RaX0r39/Trakya-Rocket-Unfinished/avionics/RakentenGörevyükü.png

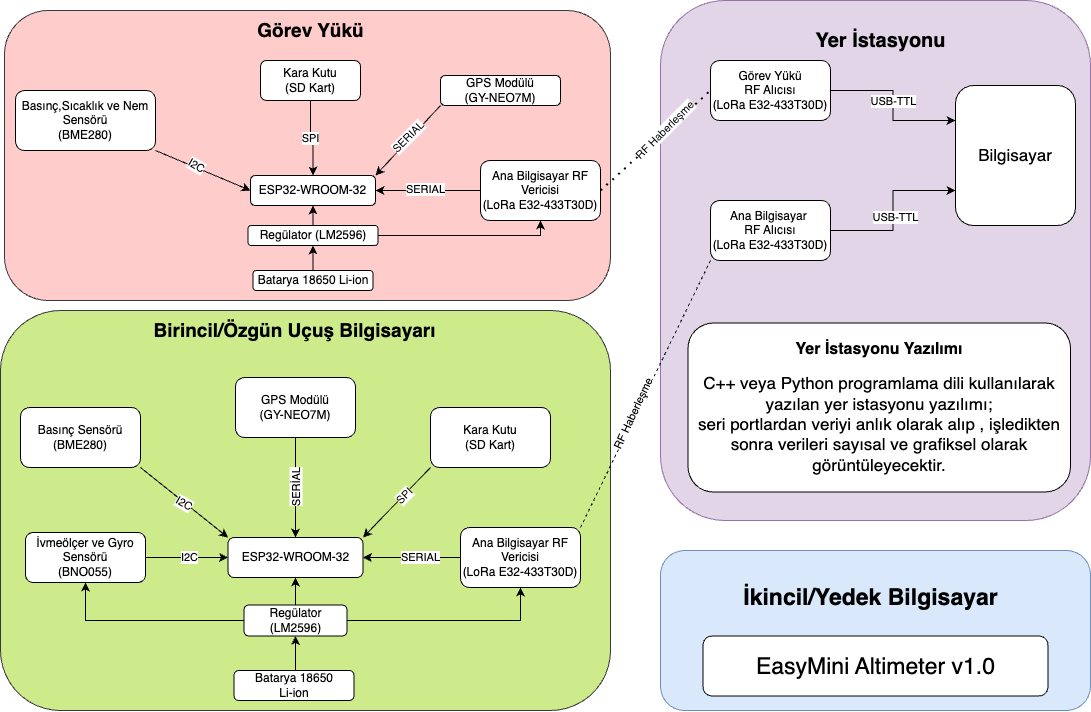
avionics/RakentenGörevyükü.png
