RaX0r39/Trakya-Rocket-Unfinished/avionics/RaketenSchema.png

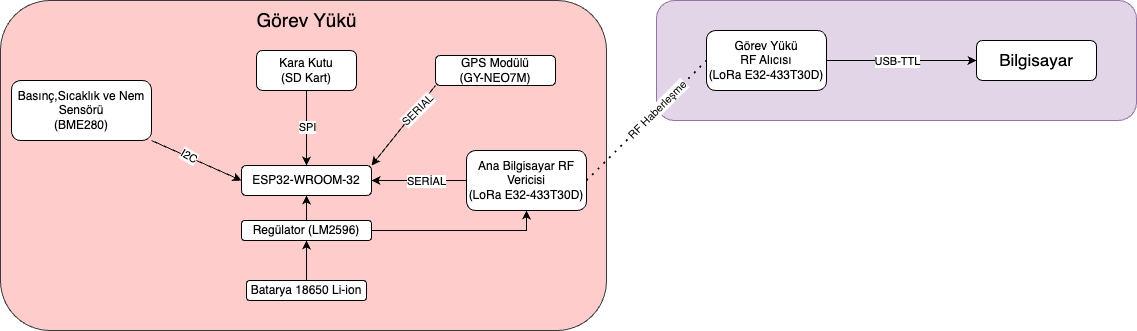
avionics/RaketenSchema.png
