RaX0r39/Trakya-Rocket-Unfinished/mechanics/kurtarma sistemi montajlı hal son.SLDASM

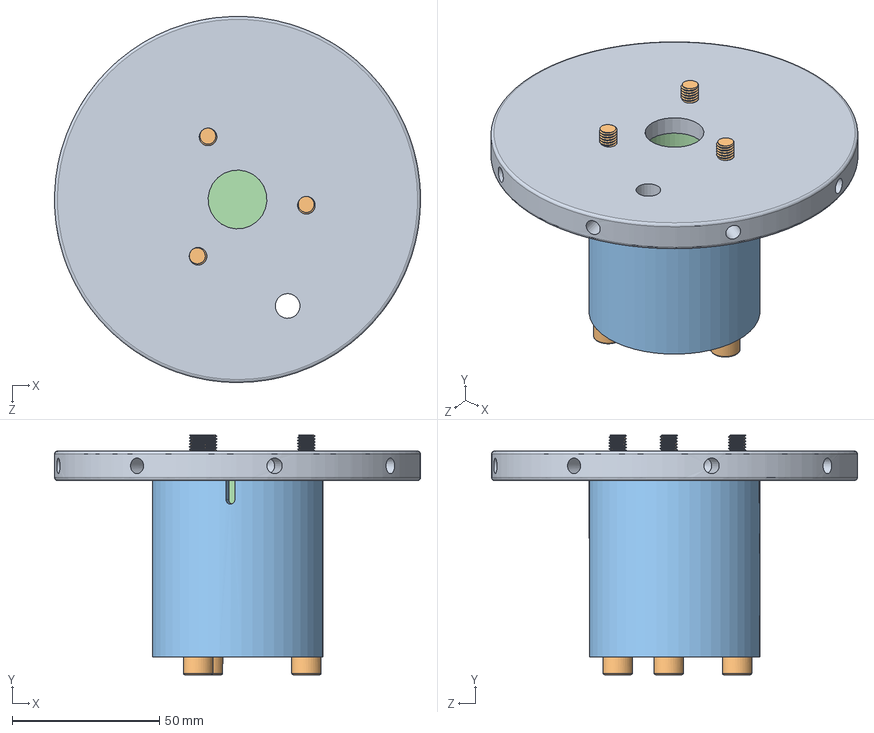
[picture p34: CAD file, 2025-07-06]
mechanics/kurtarma sistemi montajlı hal son.SLDASM
124.4 x 81.4 x 124.4 mm
piroteknik_kapsul_arayuz
piroteknik1
piroteknik kapsül muhafaza
alyan x 3
Kurtarma Merkezleme Bileziği
