RaX0r39/Trakya-Rocket-Unfinished/mechanics/Lora E32.SLDPRT

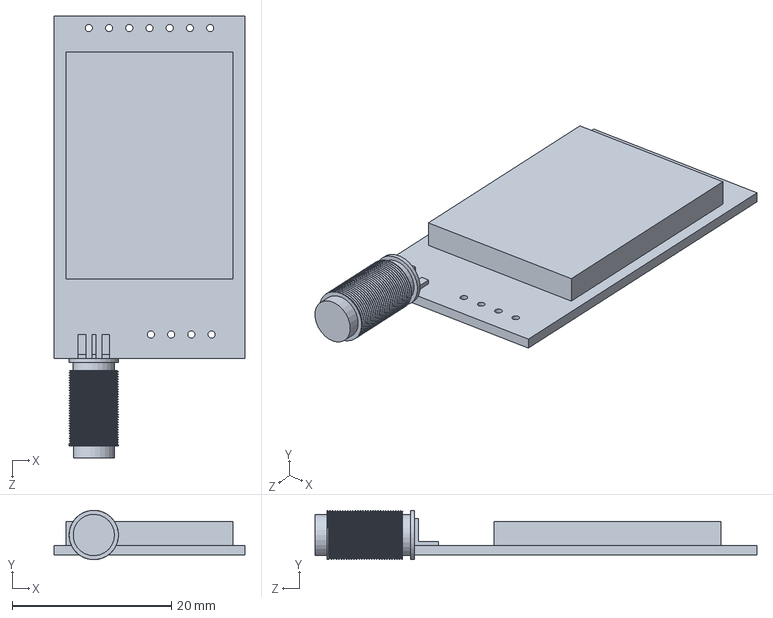
[picture p35: CAD file, 2025-07-06]
mechanics/Lora E32.SLDPRT
24.0 x 6.20 x 55.5 mm
