RaX0r39/Trakya-Rocket-Unfinished/mechanics/Görev Yükü Yük AISI 304.SLDPRT

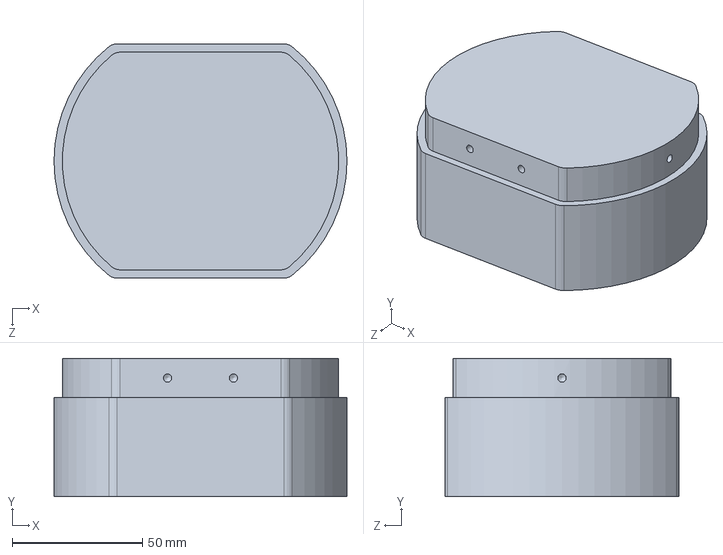
[picture p36: CAD file, 2025-07-06]
mechanics/Görev Yükü Yük AISI 304.SLDPRT
112.5 x 53.0 x 90.0 mm
