RaX0r39/Trakya-Rocket-Unfinished/mechanics/aviyonik_pcb_2.SLDPRT

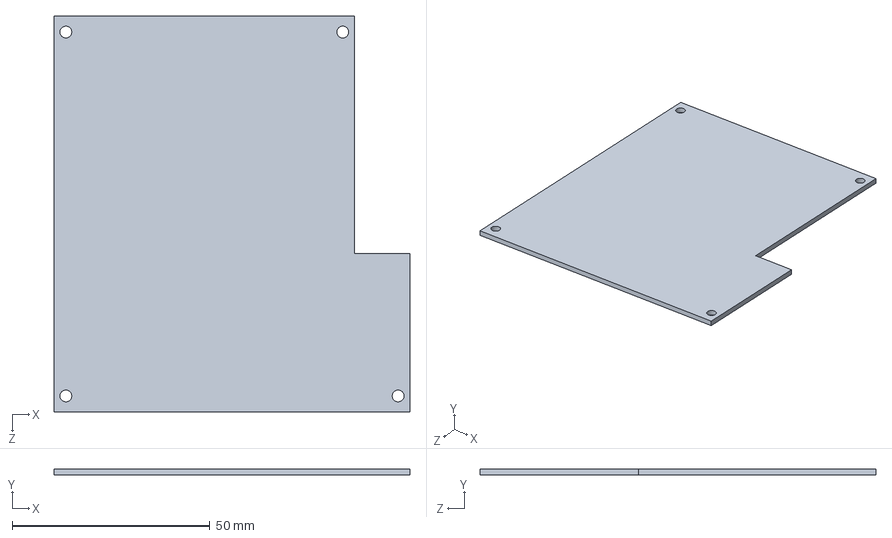
[picture p37: CAD file, 2025-07-06]
mechanics/aviyonik_pcb_2.SLDPRT
90.0 x 1.60 x 100.0 mm
