RaX0r39/Trakya-Rocket-Unfinished/mechanics/Aviyonik Muhafaza.SLDPRT

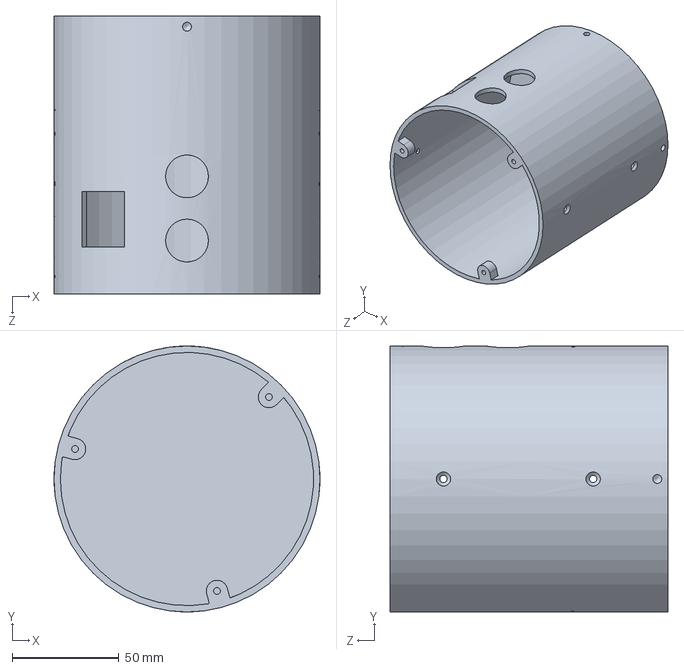
[picture p38: CAD file, 2025-07-06]
mechanics/Aviyonik Muhafaza.SLDPRT
124.4 x 124.4 x 130.0 mm
