RaX0r39/Trakya-Rocket-Unfinished/mechanics/piroteknik kapsül muhafaza.SLDPRT

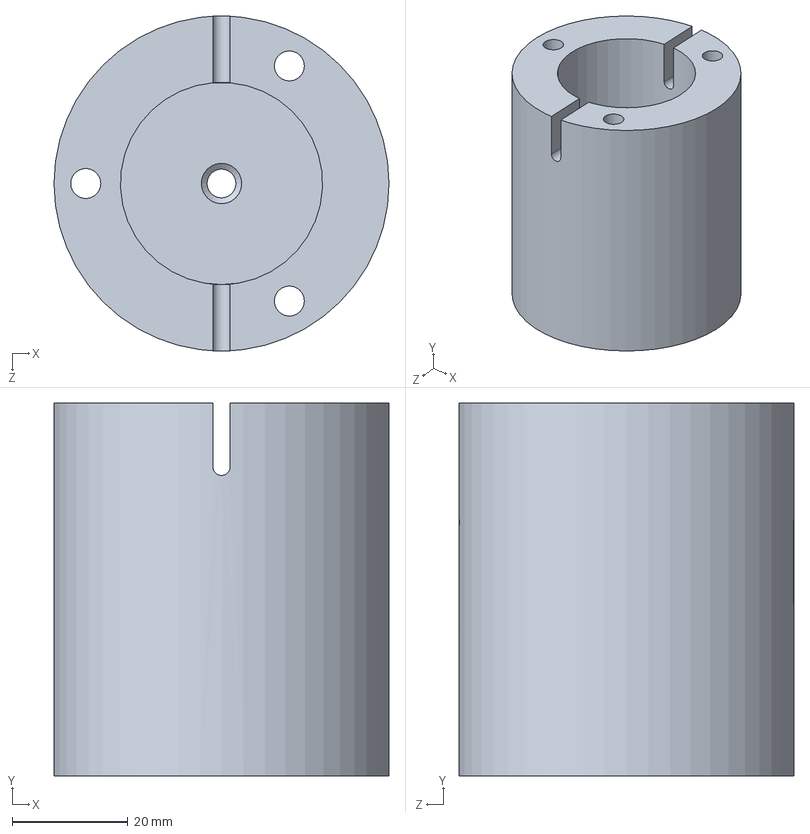
[picture p39: CAD file, 2025-07-06]
mechanics/piroteknik kapsül muhafaza.SLDPRT
58.0 x 64.5 x 58.0 mm
