RaX0r39/Trakya-Rocket-Unfinished/mechanics/M1850.SLDPRT

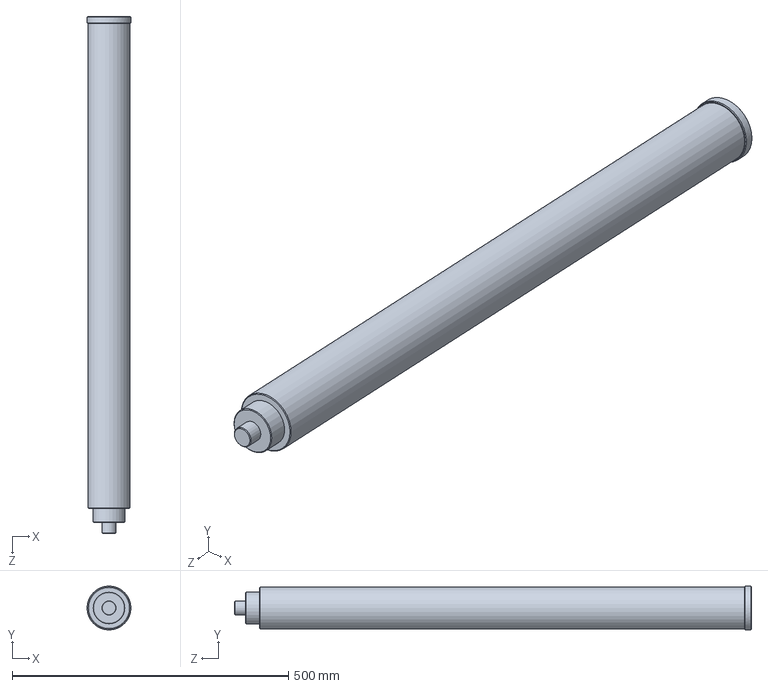
[picture p40: CAD file, 2025-07-06]
mechanics/M1850.SLDPRT
79.4 x 79.3 x 935.4 mm
