RaX0r39/Trakya-Rocket-Unfinished/mechanics/Gövde Kapağı.SLDPRT

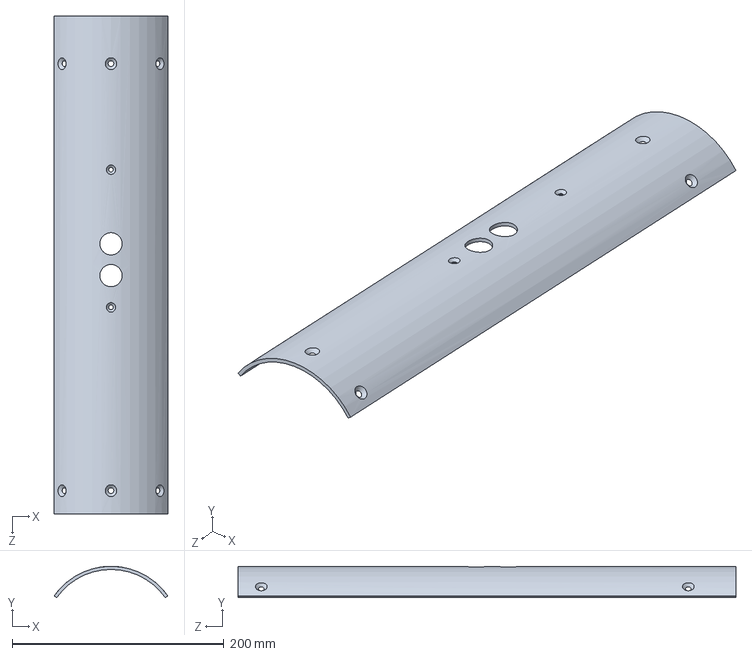
[picture p41: CAD file, 2025-07-06]
mechanics/Gövde Kapağı.SLDPRT
107.3 x 29.7 x 470.0 mm
