RaX0r39/Trakya-Rocket-Unfinished/mechanics/Alt Gövde.SLDPRT

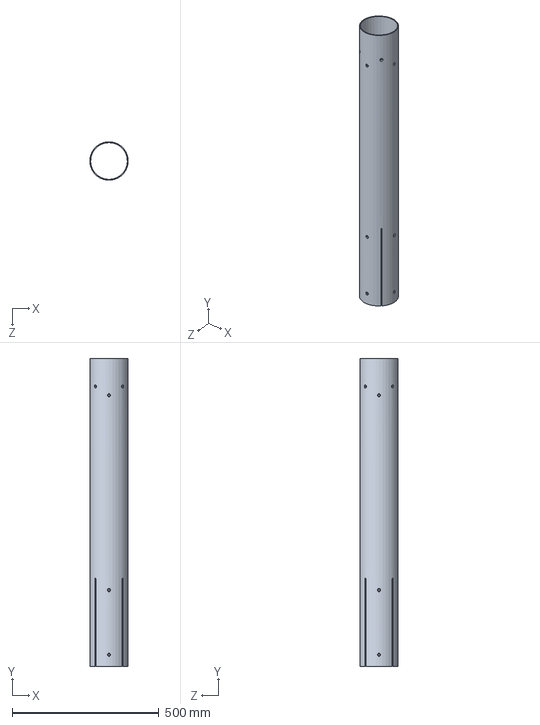
[picture p42: CAD file, 2025-07-06]
mechanics/Alt Gövde.SLDPRT
131.0 x 1050.0 x 131.0 mm
