RaX0r39/Trakya-Rocket-Unfinished/mechanics/m8 kurtarma mapası.SLDPRT

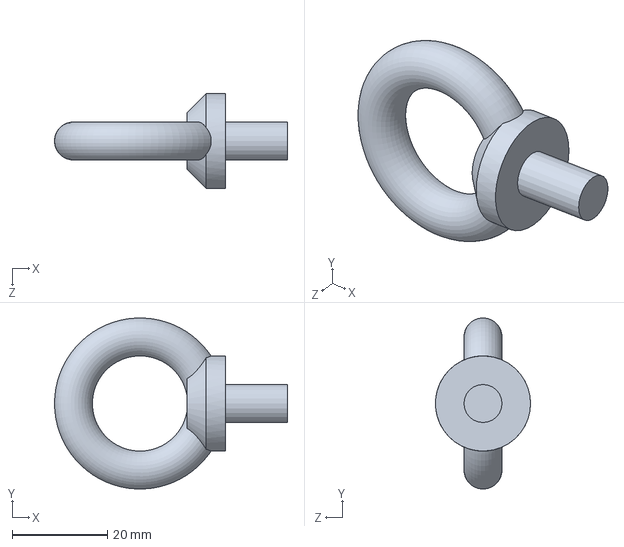
[picture p43: CAD file, 2025-07-06]
mechanics/m8 kurtarma mapası.SLDPRT
49.0 x 35.9 x 20.0 mm
