RaX0r39/Trakya-Rocket-Unfinished/mechanics/Üst Gövde.SLDPRT

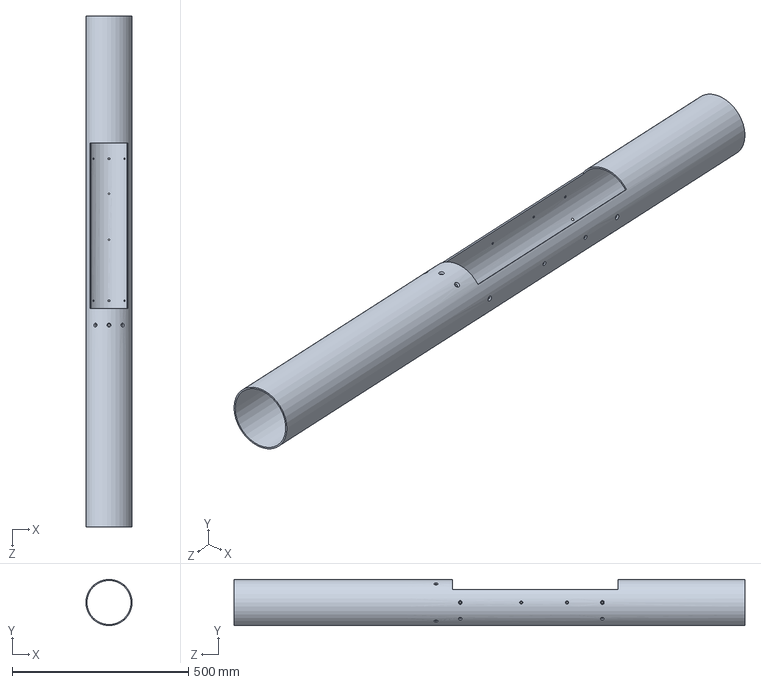
[picture p44: CAD file, 2025-07-06]
mechanics/Üst Gövde.SLDPRT
131.0 x 131.0 x 1450.0 mm
