RaX0r39/Trakya-Rocket-Unfinished/mechanics/GörevYükü Ana Duvar Arge.SLDPRT

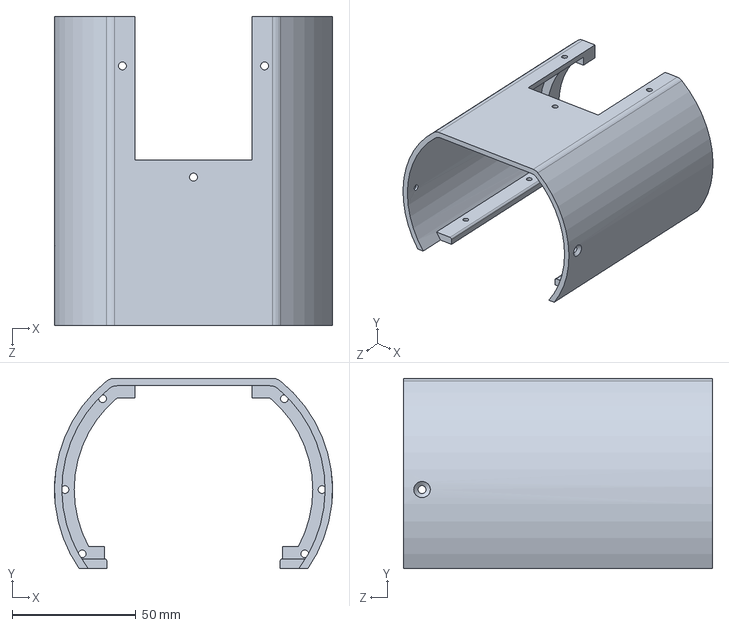
[picture p45: CAD file, 2025-07-06]
mechanics/GörevYükü Ana Duvar Arge.SLDPRT
112.5 x 77.0 x 125.0 mm
