RaX0r39/Trakya-Rocket-Unfinished/mechanics/alt merkezleme bloğu.SLDPRT

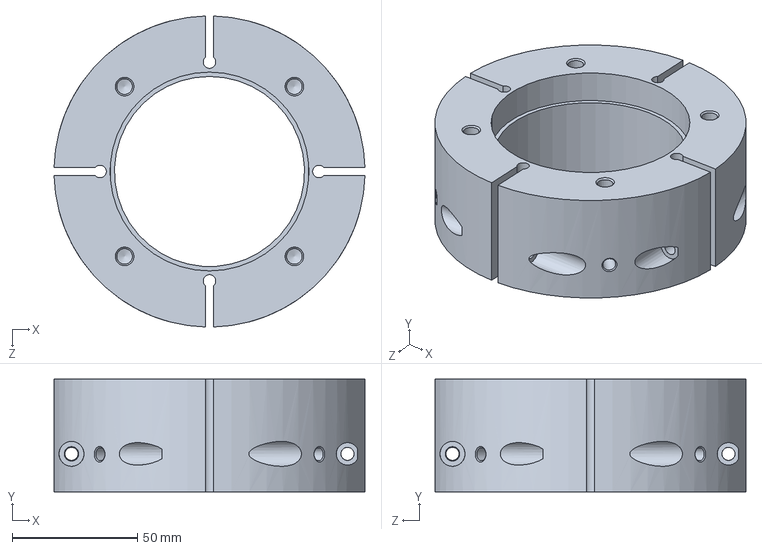
[picture p46: CAD file, 2025-07-06]
mechanics/alt merkezleme bloğu.SLDPRT
124.4 x 45.0 x 124.4 mm
