RaX0r39/Trakya-Rocket-Unfinished/mechanics/A_GPS_ant.SLDPRT

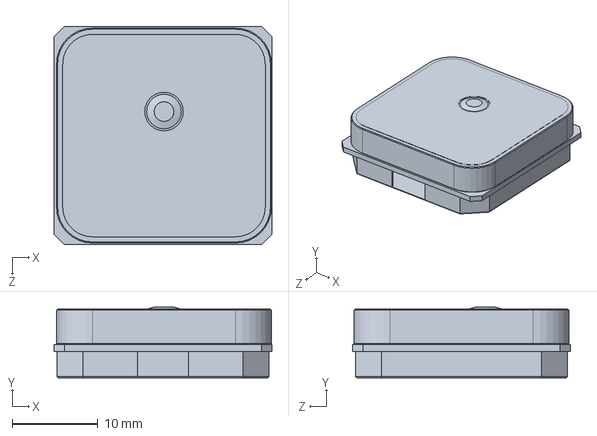
[picture p47: CAD file, 2025-07-06]
mechanics/A_GPS_ant.SLDPRT
25.4 x 8.27 x 25.4 mm
