RaX0r39/Trakya-Rocket-Unfinished/mechanics/üst merkezleme 2025.SLDPRT

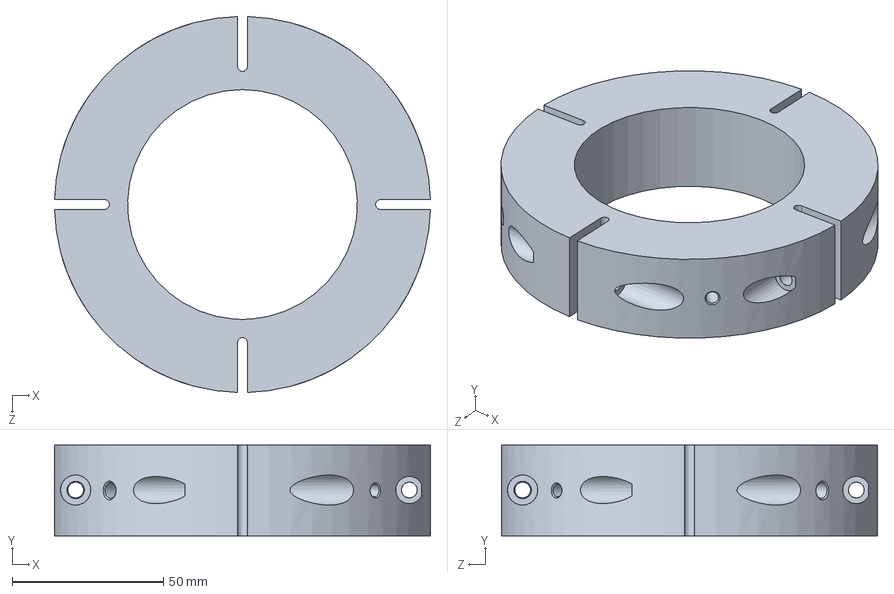
[picture p48: CAD file, 2025-07-06]
mechanics/üst merkezleme 2025.SLDPRT
124.4 x 30.0 x 124.4 mm
