RaX0r39/Trakya-Rocket-Unfinished/mechanics/Görev Yükü GPS Duvarı.SLDPRT

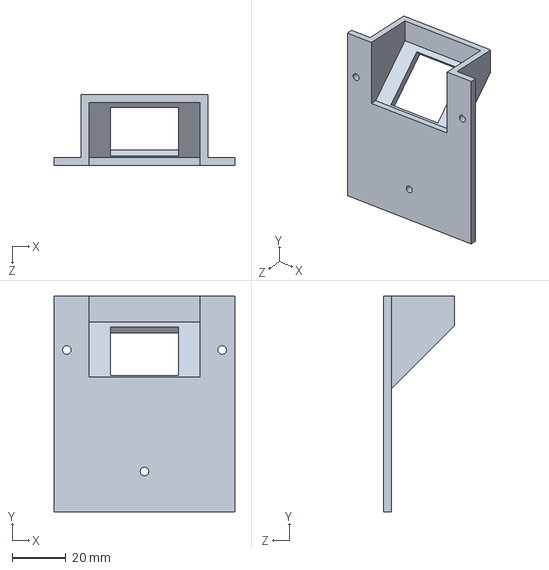
[picture p49: CAD file, 2025-07-06]
mechanics/Görev Yükü GPS Duvarı.SLDPRT
67.0 x 80.0 x 26.3 mm
