RaX0r39/Trakya-Rocket-Unfinished/mechanics/Adafruit BNO055 STEMMA QT.step

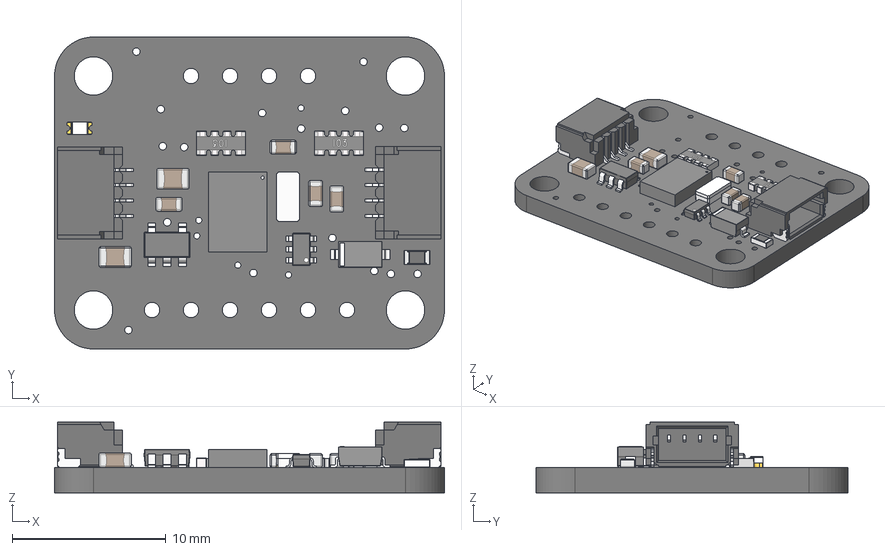
[picture p50: CAD file, 2025-07-06]
mechanics/Adafruit BNO055 STEMMA QT.step
25.4 x 20.3 x 4.60 mm
Printed Circuit Board
BNO055-9axis-IMU
Crystal_XTAL3215_32.768KHz
SOT23-5
SOT23-6
Cathode
Anode
Cathode Bar
LED 0603 single color
CAPC-0805-T0.95-BN x 2
CAPC-0603-T0.9-BN x 4
RESC-0603
YC164_RESPACK x 2
qwicc x 2
