RaX0r39/Trakya-Rocket-Unfinished/mechanics/lm2596.stp

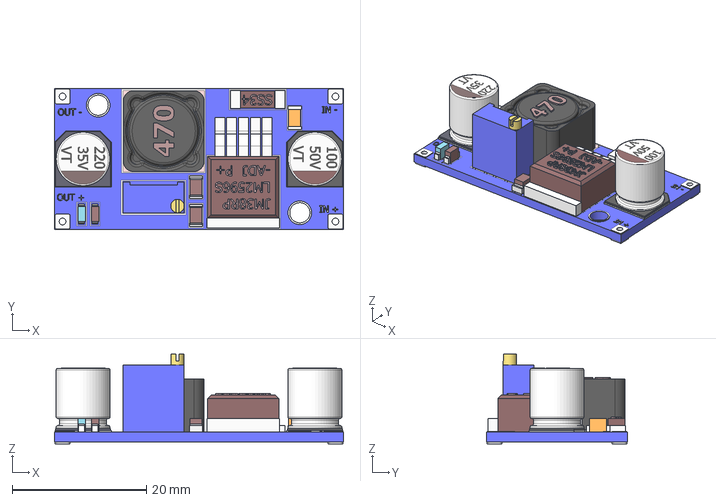
[picture p51: CAD file, 2025-07-06]
mechanics/lm2596.stp
43.0 x 21.0 x 13.3 mm
