RaX0r39/Trakya-Rocket-Unfinished/mechanics/anten_dik.SLDPRT

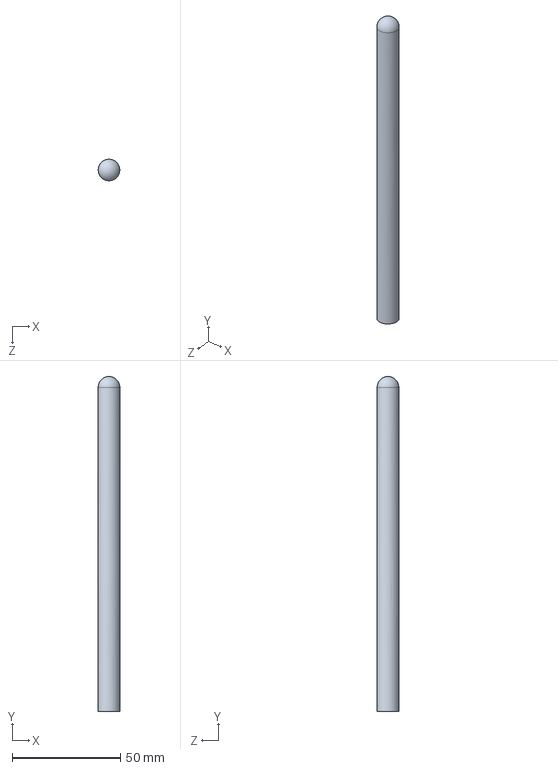
[picture p52: CAD file, 2025-07-06]
mechanics/anten_dik.SLDPRT
10.0 x 155.0 x 10.0 mm
