RaX0r39/Trakya-Rocket-Unfinished/mechanics/Aviyonik iç duvar.SLDPRT

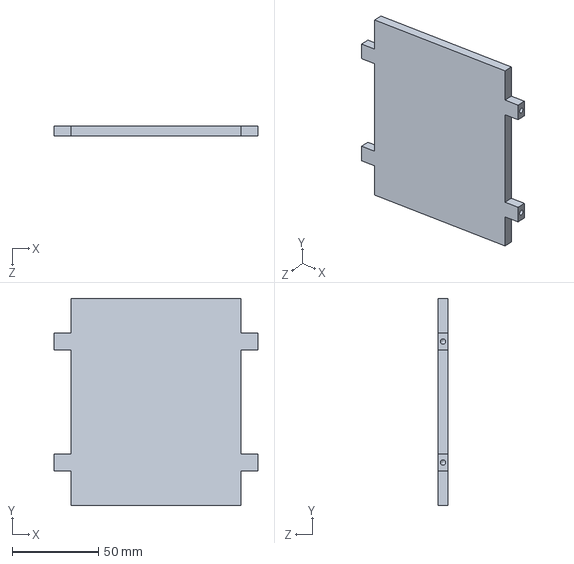
[picture p53: CAD file, 2025-07-06]
mechanics/Aviyonik iç duvar.SLDPRT
118.0 x 120.0 x 6.00 mm
