RaX0r39/Trakya-Rocket-Unfinished/mechanics/Görev Yükü Tutucu Bilezik.SLDPRT

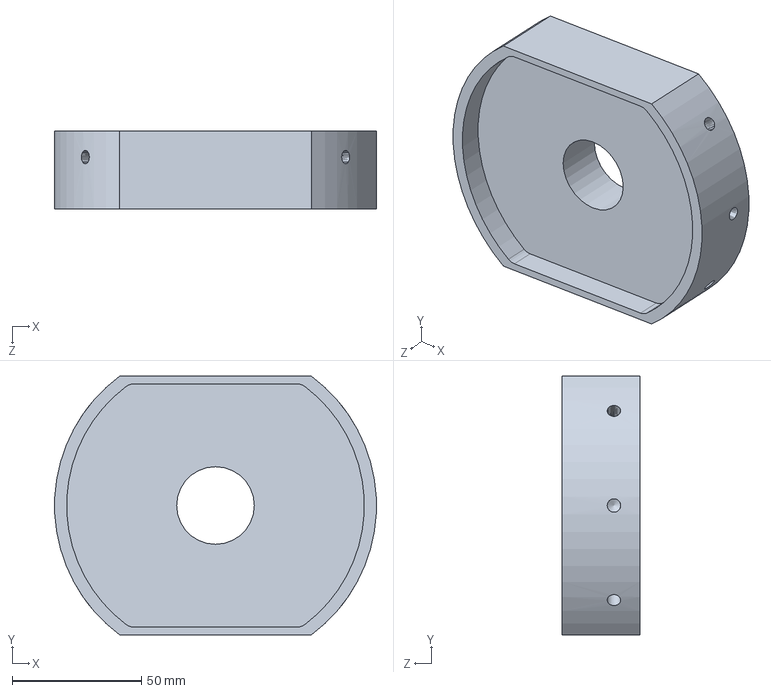
[picture p54: CAD file, 2025-07-06]
mechanics/Görev Yükü Tutucu Bilezik.SLDPRT
124.4 x 100.0 x 30.0 mm
