RaX0r39/Trakya-Rocket-Unfinished/mechanics/Adafruit VL6180 STEMMA QT.step

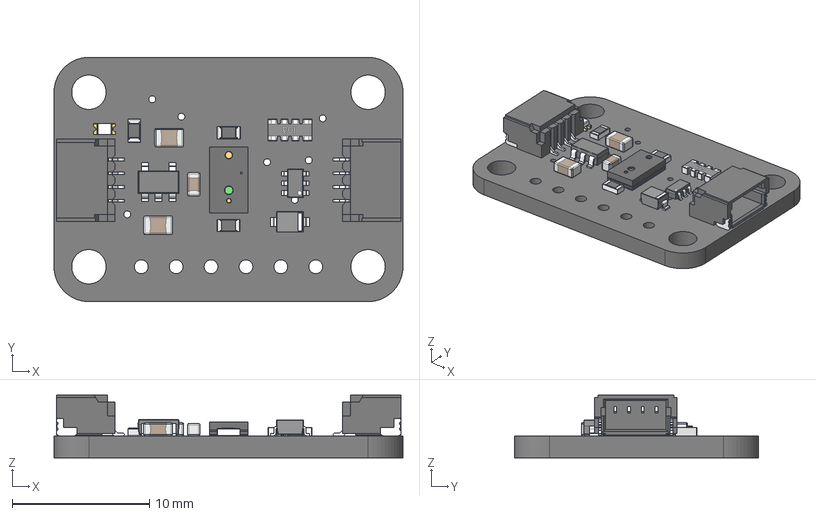
[picture p55: CAD file, 2025-07-06]
mechanics/Adafruit VL6180 STEMMA QT.step
25.4 x 17.8 x 4.55 mm
Printed Circuit Board
VL6180X_PART1
VL6180X_PART2
VL6180X_PART3
VL6180X_PART4
VL6180X_PART5 x 12
Lens 1
Lens 2
Lens 3
SOT23-5
SOT23-6
YC164_RESPACK
LED 0603 single color
Cathode
Anode
Cathode Bar
CAPC-0603-T0.9-BN
CAPC-0805-T0.95-BN x 2
RESC-0603 x 3
qwicc x 2
