RaX0r39/Trakya-Rocket-Unfinished/mechanics/Kurtarma Merkezleme Bileziği.SLDPRT

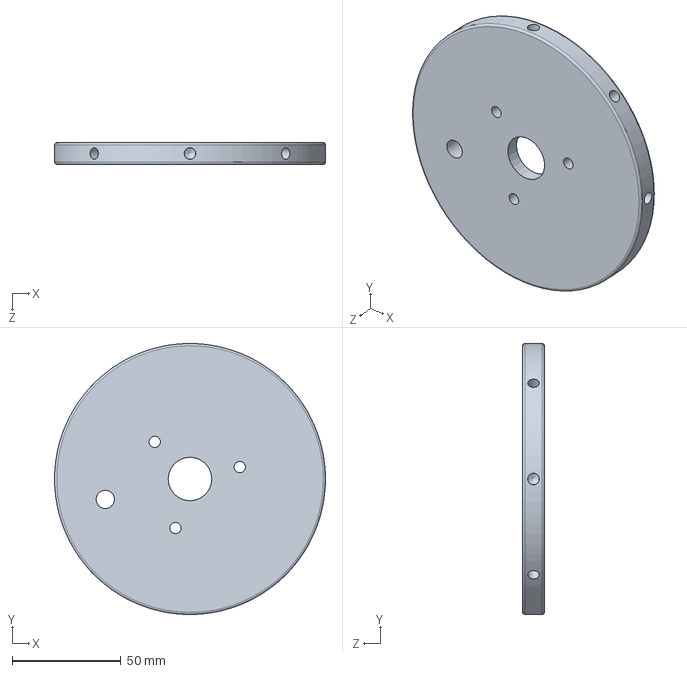
[picture p56: CAD file, 2025-07-06]
mechanics/Kurtarma Merkezleme Bileziği.SLDPRT
124.4 x 124.4 x 10.0 mm
