RaX0r39/Trakya-Rocket-Unfinished/mechanics/piroteknik_kapsul_arayuz.SLDPRT

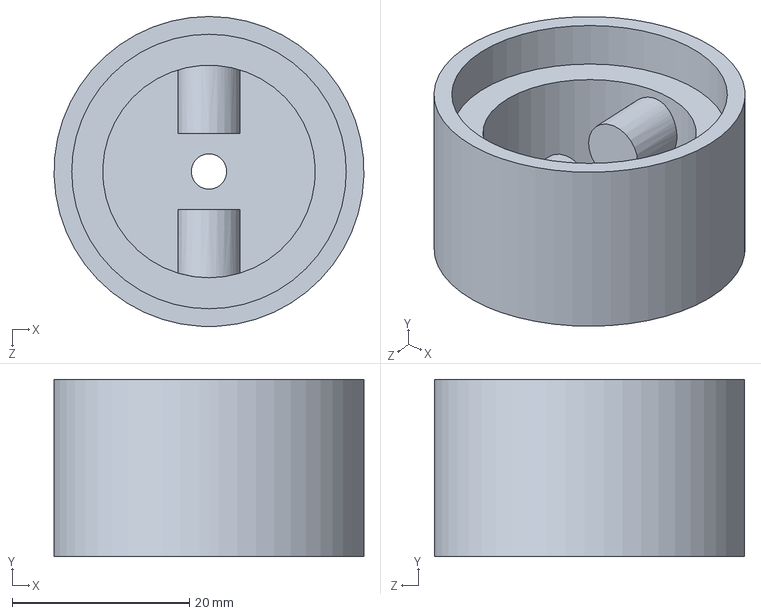
[picture p57: CAD file, 2025-07-06]
mechanics/piroteknik_kapsul_arayuz.SLDPRT
35.0 x 20.0 x 35.0 mm
