RaX0r39/Trakya-Rocket-Unfinished/mechanics/Görev Yükü yeni swich duvar.SLDPRT

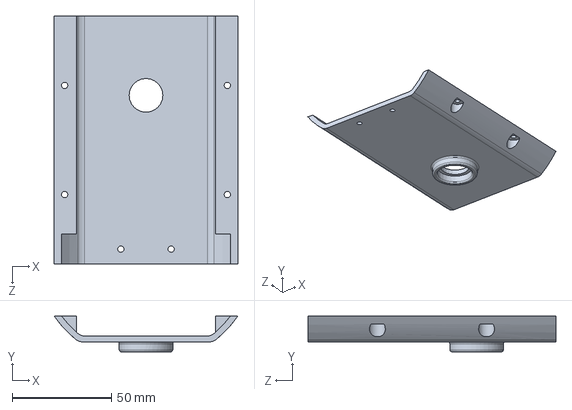
[picture p58: CAD file, 2025-07-06]
mechanics/Görev Yükü yeni swich duvar.SLDPRT
92.5 x 18.0 x 125.0 mm
