RaX0r39/Trakya-Rocket-Unfinished/mechanics/Asıl Üst Motor Tutucu.SLDPRT

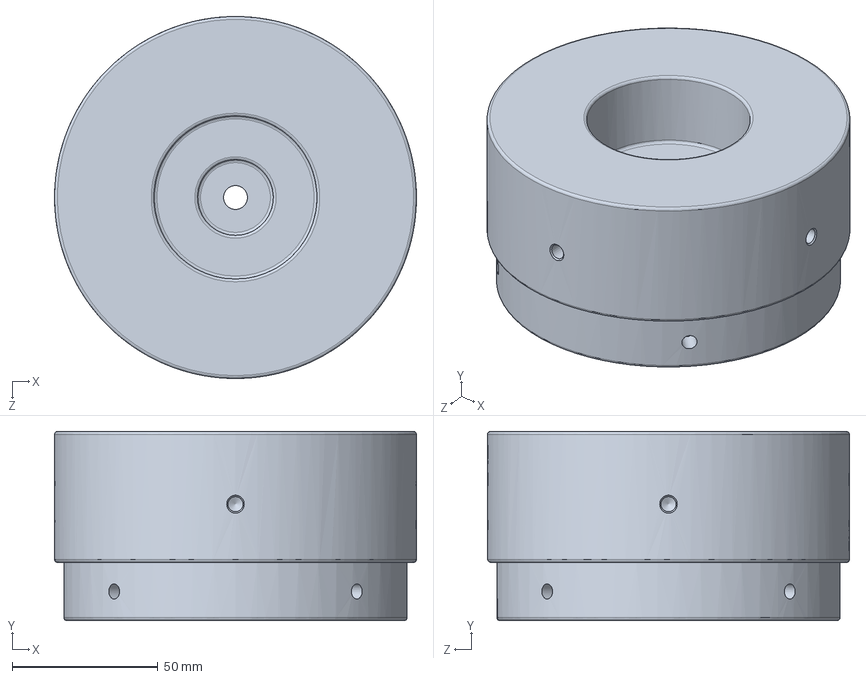
[picture p59: CAD file, 2025-07-06]
mechanics/Asıl Üst Motor Tutucu.SLDPRT
124.4 x 65.0 x 124.4 mm
