RaX0r39/Trakya-Rocket-Unfinished/mechanics/hakem_altimetresi.SLDPRT

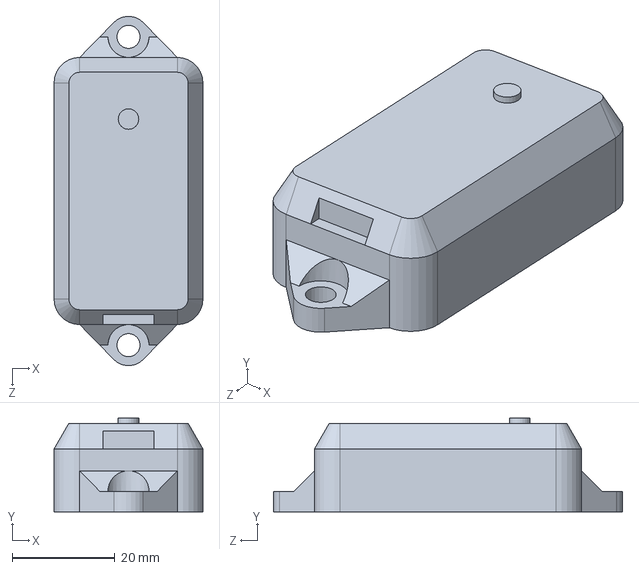
[picture p60: CAD file, 2025-07-06]
mechanics/hakem_altimetresi.SLDPRT
29.0 x 18.2 x 67.9 mm
