RaX0r39/Trakya-Rocket-Unfinished/mechanics/aviyonik üst kapak.SLDPRT

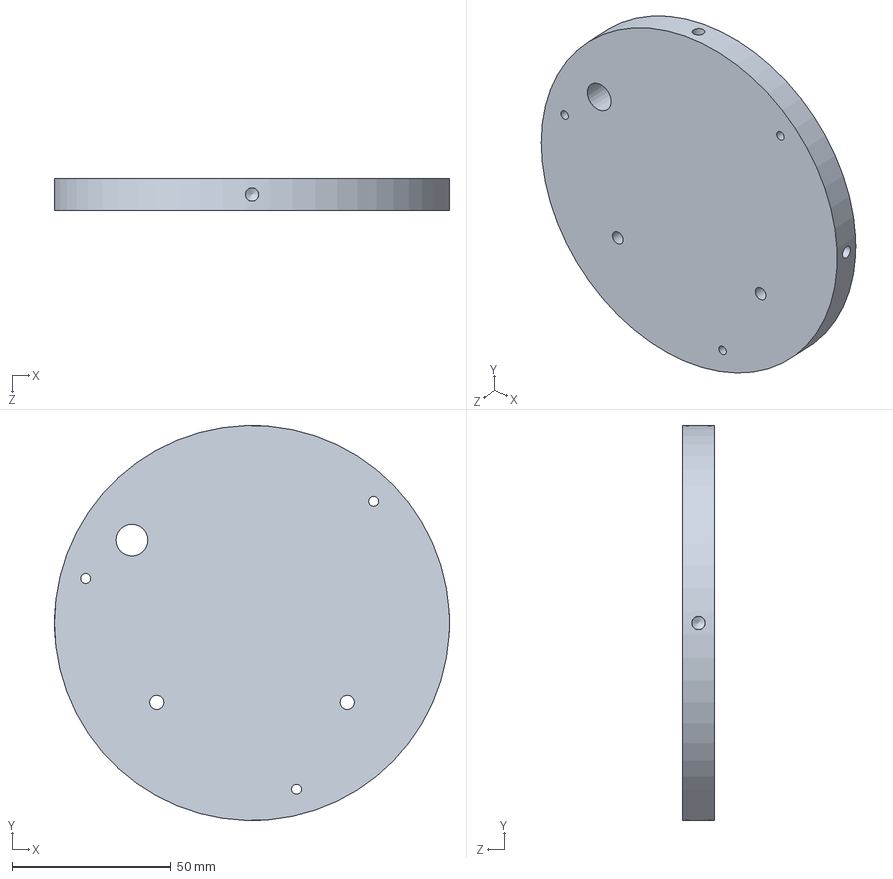
[picture p61: CAD file, 2025-07-06]
mechanics/aviyonik üst kapak.SLDPRT
124.4 x 124.4 x 10.0 mm
