RaX0r39/Trakya-Rocket-Unfinished/mechanics/surukleme_parasut.SLDPRT

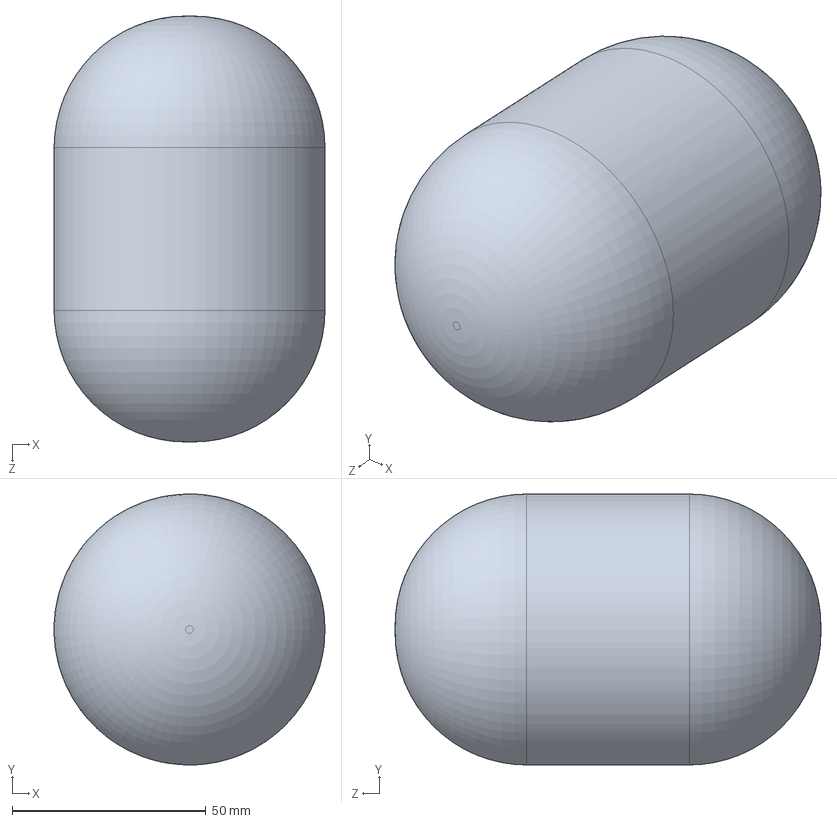
[picture p62: CAD file, 2025-07-06]
mechanics/surukleme_parasut.SLDPRT
70.0 x 70.0 x 110.0 mm
