RaX0r39/Trakya-Rocket-Unfinished/mechanics/burun konisi duvarı.SLDPRT

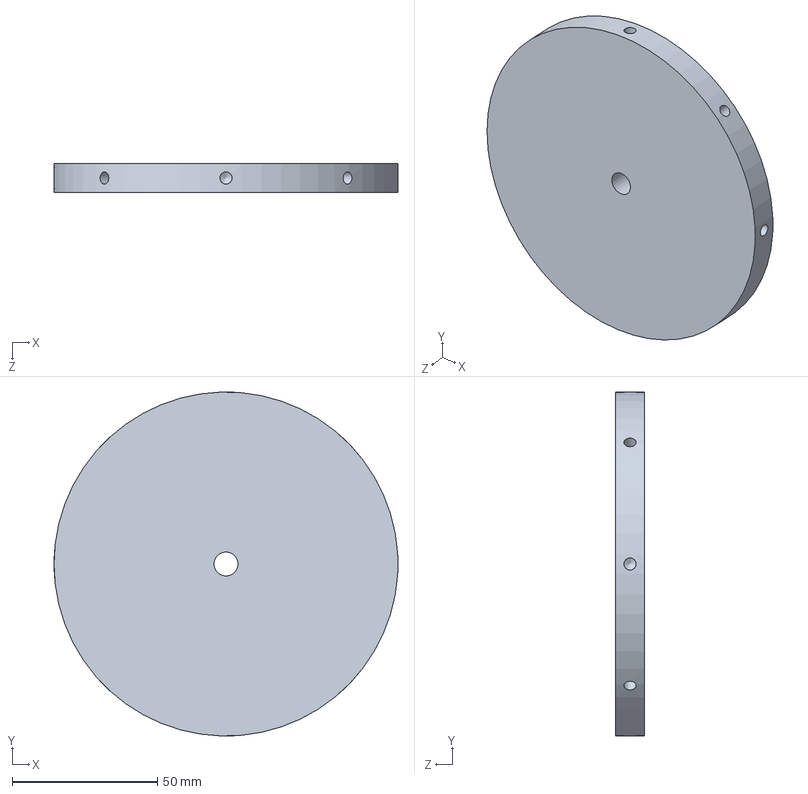
[picture p63: CAD file, 2025-07-06]
mechanics/burun konisi duvarı.SLDPRT
118.4 x 118.4 x 10.0 mm
