RaX0r39/Trakya-Rocket-Unfinished/mechanics/burun konisi havşalı.SLDPRT

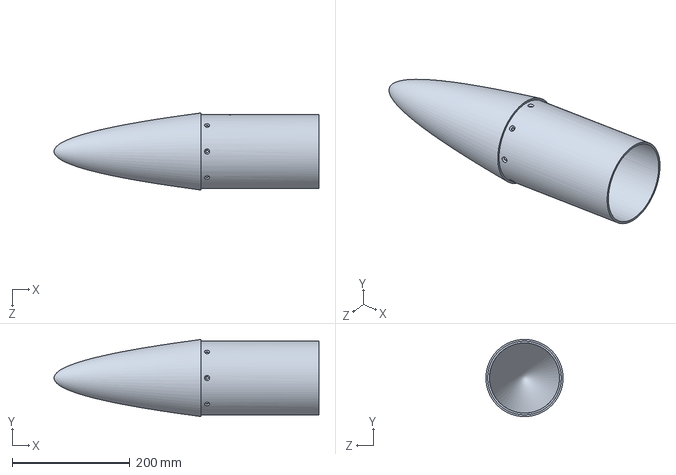
[picture p64: CAD file, 2025-07-06]
mechanics/burun konisi havşalı.SLDPRT
450.0 x 131.1 x 131.1 mm
