RaX0r39/Trakya-Rocket-Unfinished/mechanics/Адаптер micro SD.STEP

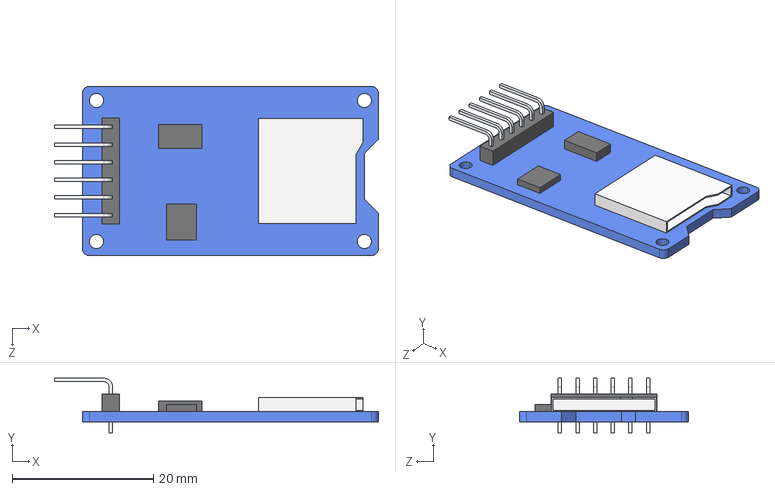
[picture p65: CAD file, 2025-07-06]
mechanics/Адаптер micro SD.STEP
45.9 x 7.75 x 24.0 mm
