RaX0r39/Trakya-Rocket-Unfinished/mechanics/alyan.SLDPRT

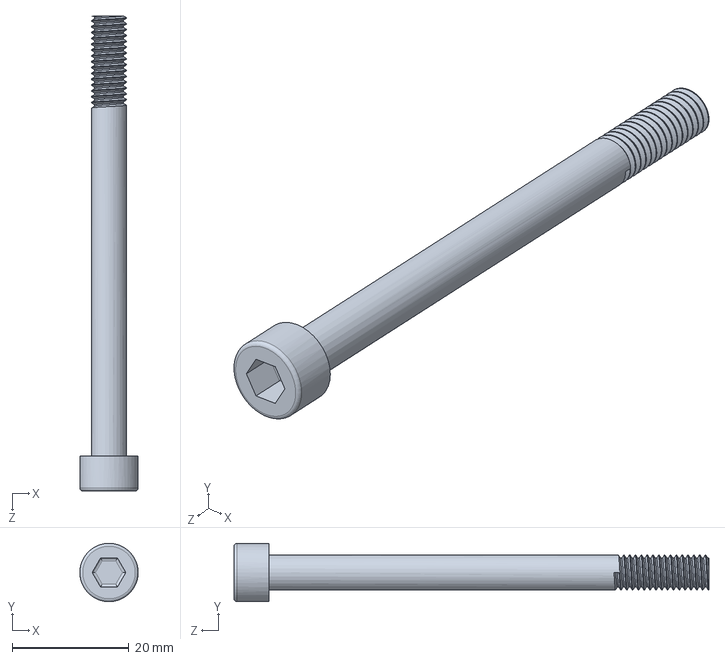
[picture p66: CAD file, 2025-07-06]
mechanics/alyan.SLDPRT
10.0 x 10.0 x 81.4 mm
