RaX0r39/Trakya-Rocket-Unfinished/mechanics/Gorev_yuku_parasut.SLDPRT

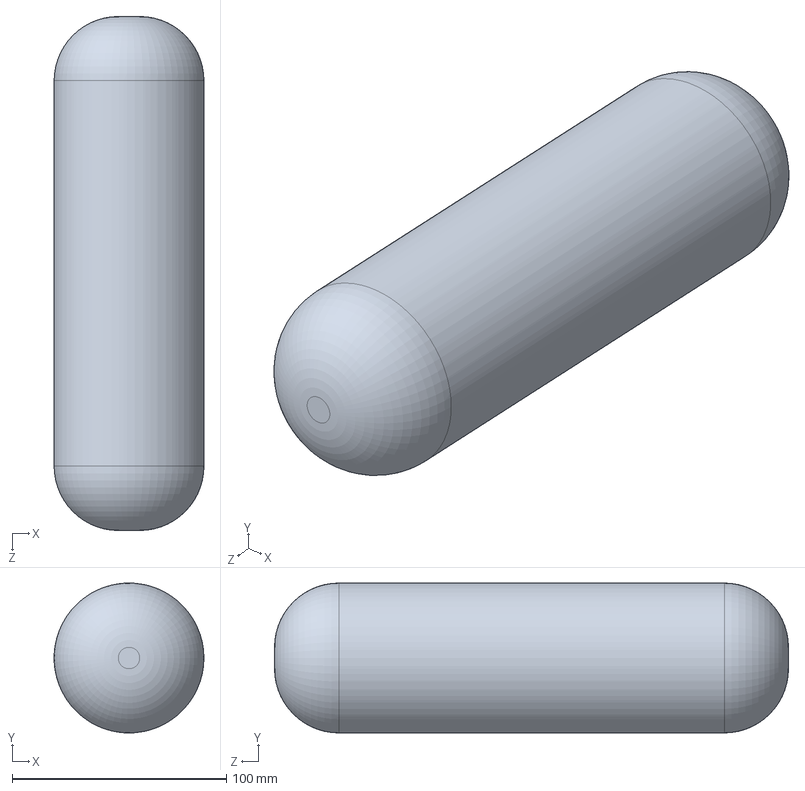
[picture p67: CAD file, 2025-07-06]
mechanics/Gorev_yuku_parasut.SLDPRT
70.0 x 70.0 x 240.0 mm
