RaX0r39/Trakya-Rocket-Unfinished/mechanics/çöp gövde.SLDPRT

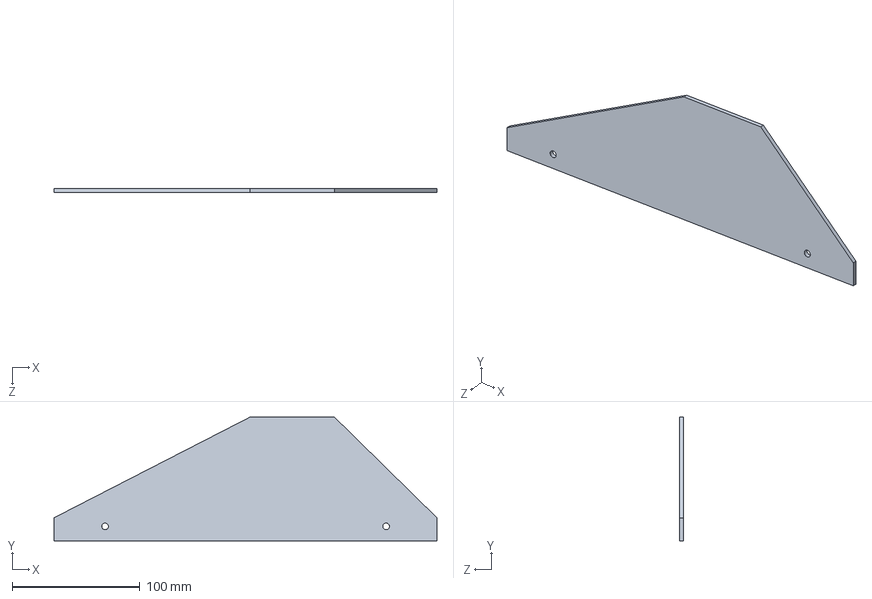
[picture p68: CAD file, 2025-07-06]
mechanics/çöp gövde.SLDPRT
300.0 x 96.8 x 3.00 mm
