RaX0r39/Trakya-Rocket-Unfinished/mechanics/Entegrasyon gövdesi.SLDPRT

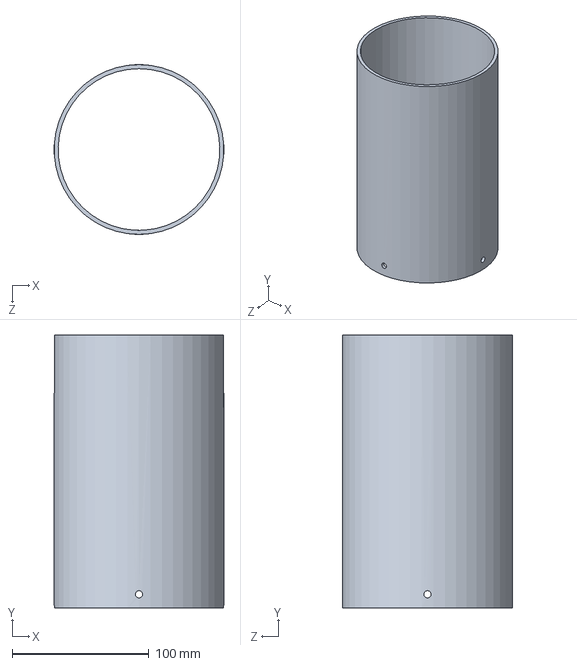
[picture p69: CAD file, 2025-07-06]
mechanics/Entegrasyon gövdesi.SLDPRT
124.4 x 200.0 x 124.4 mm
