RaX0r39/Trakya-Rocket-Unfinished/mechanics/Ana_parasut.SLDPRT

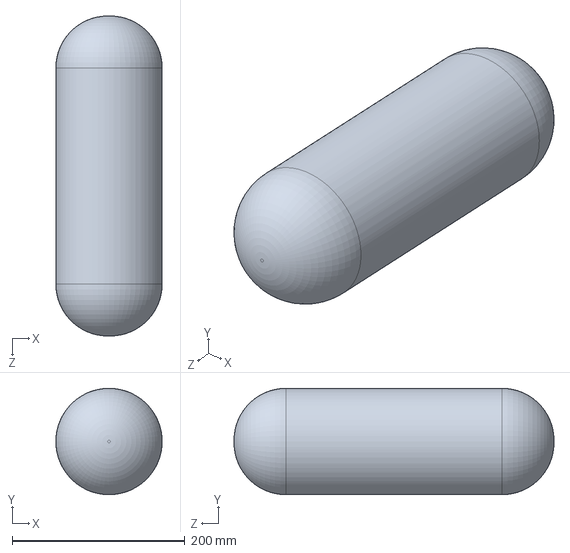
[picture p70: CAD file, 2025-07-06]
mechanics/Ana_parasut.SLDPRT
123.0 x 123.0 x 370.0 mm
