RaX0r39/Trakya-Rocket-Unfinished/mechanics/2025 ROKET ALT MOTOR TUTUCU.SLDPRT

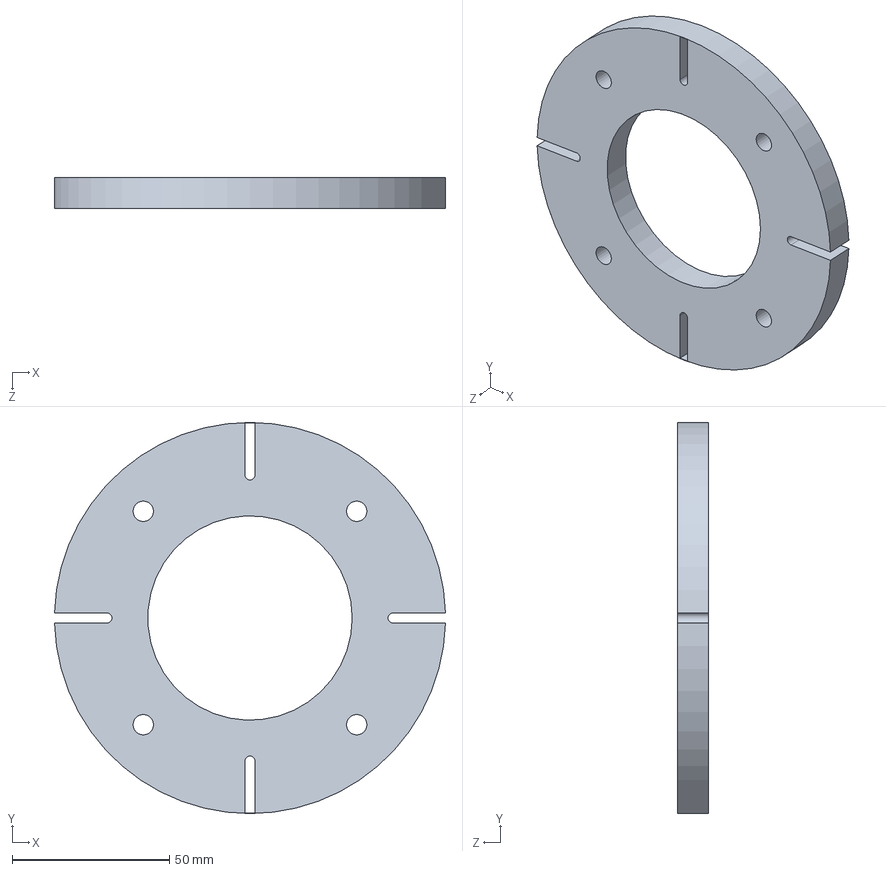
[picture p71: CAD file, 2025-07-06]
mechanics/2025 ROKET ALT MOTOR TUTUCU.SLDPRT
124.4 x 124.4 x 10.0 mm
