RaX0r39/Trakya-Rocket-Unfinished/mechanics/LED Push Button M15 2.SLDPRT

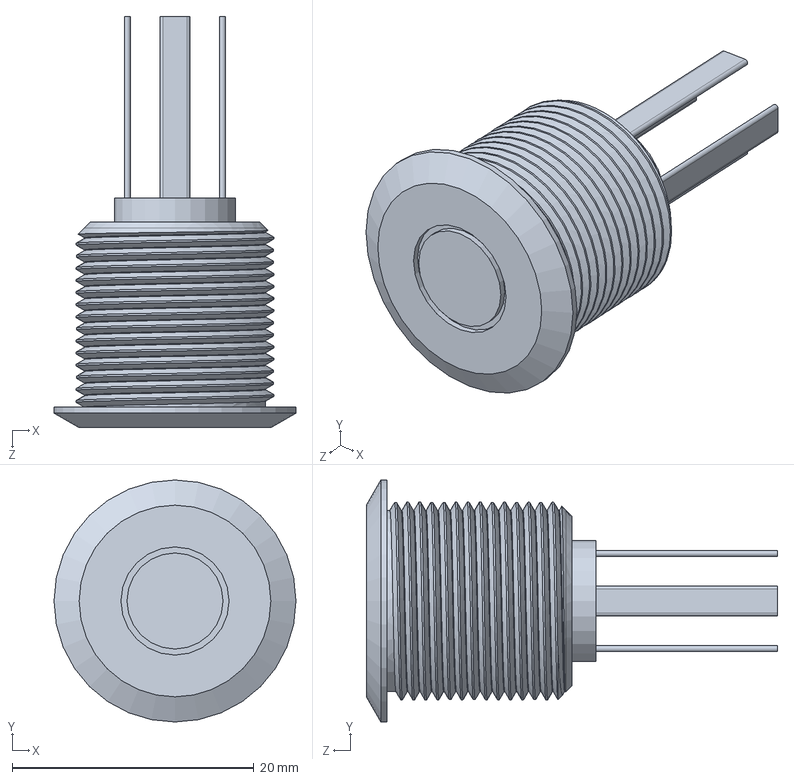
[picture p72: CAD file, 2025-07-06]
mechanics/LED Push Button M15 2.SLDPRT
20.0 x 20.0 x 34.0 mm
