RaX0r39/Trakya-Rocket-Unfinished/mechanics/piroteknik1.SLDPRT

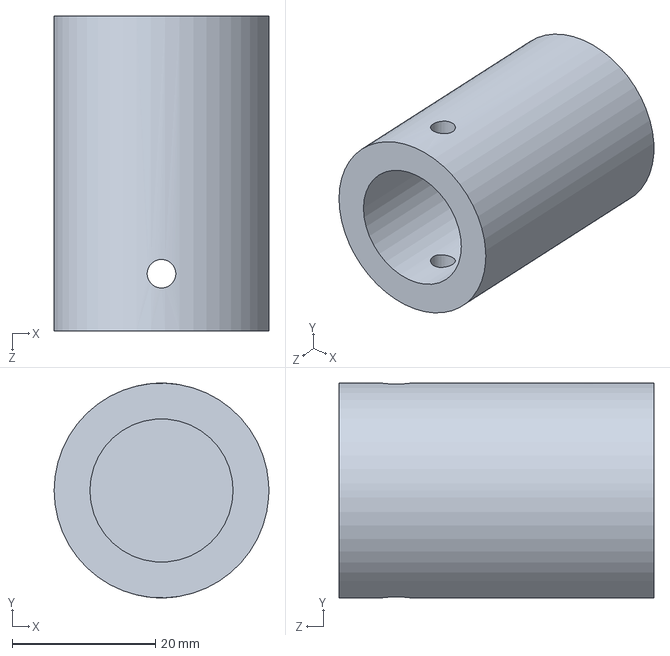
[picture p73: CAD file, 2025-07-06]
mechanics/piroteknik1.SLDPRT
30.0 x 30.0 x 44.0 mm
