RaX0r39/Trakya-Rocket-Unfinished/mechanics/GPS_ublox_board.SLDPRT

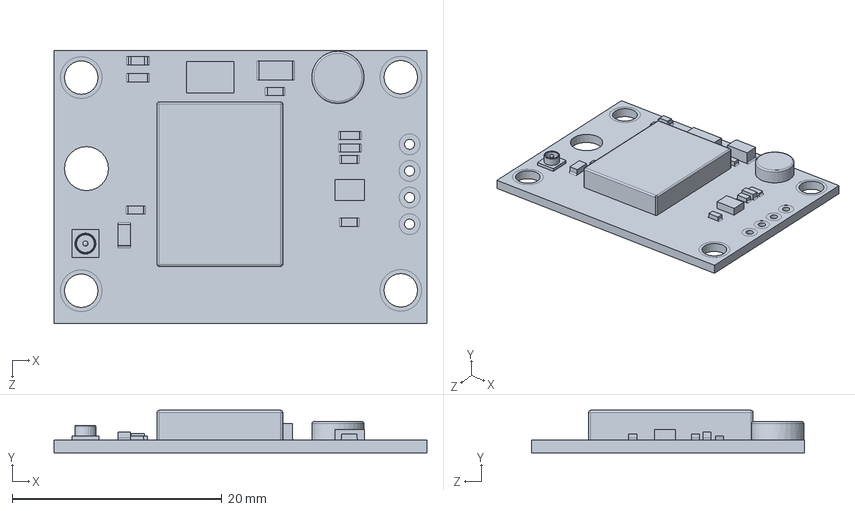
[picture p74: CAD file, 2025-07-06]
mechanics/GPS_ublox_board.SLDPRT
35.6 x 4.06 x 26.1 mm
