RaX0r39/Trakya-Rocket-Unfinished/mechanics/Görev Yükü Üst Kapak.SLDPRT

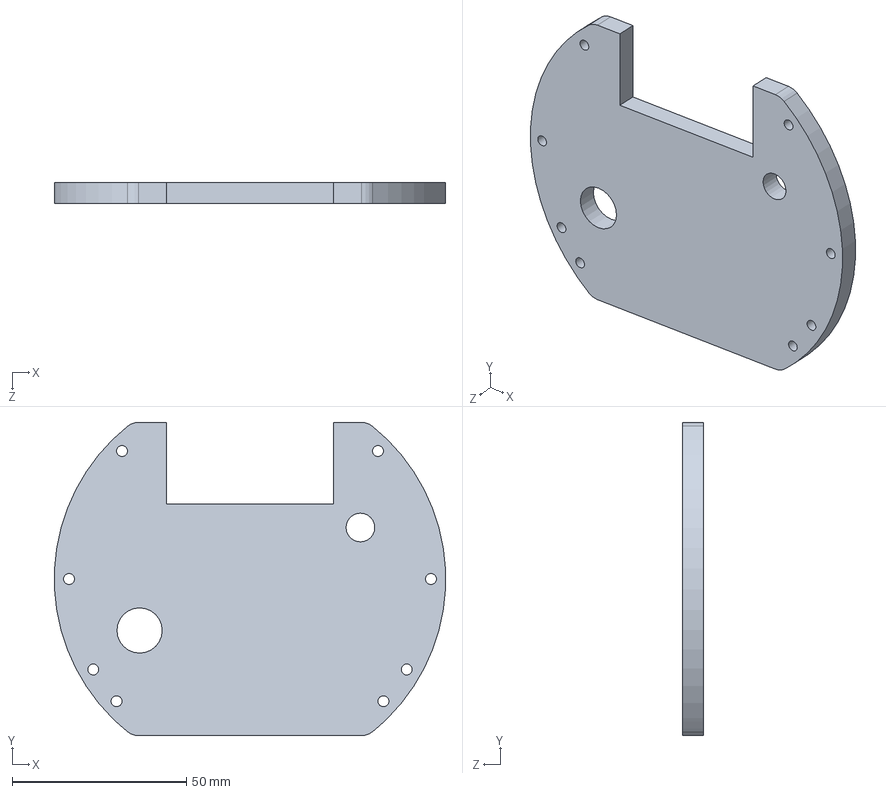
[picture p75: CAD file, 2025-07-06]
mechanics/Görev Yükü Üst Kapak.SLDPRT
112.3 x 90.0 x 6.00 mm
