RaX0r39/Trakya-Rocket-Unfinished/mechanics/Görev Yükü Montajı.SLDASM

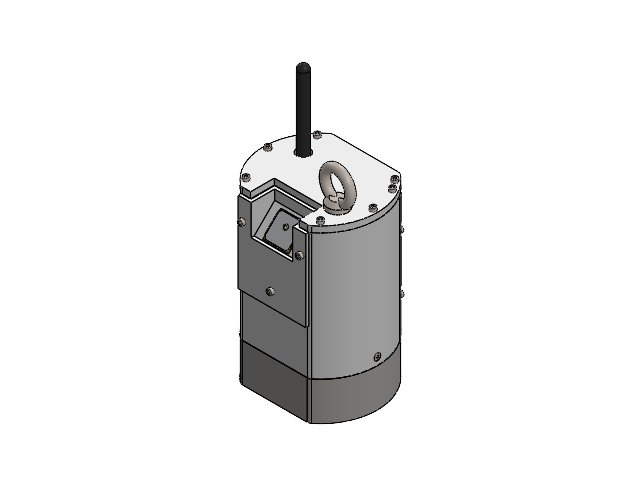
[picture p76: CAD file, 2025-07-06]
mechanics/Görev Yükü Montajı.SLDASM
Görev Yükü Yük AISI 304
GörevYükü Ana Duvar Arge
Görev Yükü yeni swich duvar
Görev Yükü GPS Duvarı
Görev Yükü Üst Kapak
A_GPS_ant
LED Push Button M15 2
socket head cap screw_iso x 17
socket countersunk head screw_iso x 3
M8 EYEBOLT
anten_dik
