RaX0r39/Trakya-Rocket-Unfinished/mechanics/Alt Gövde Montaj.SLDASM

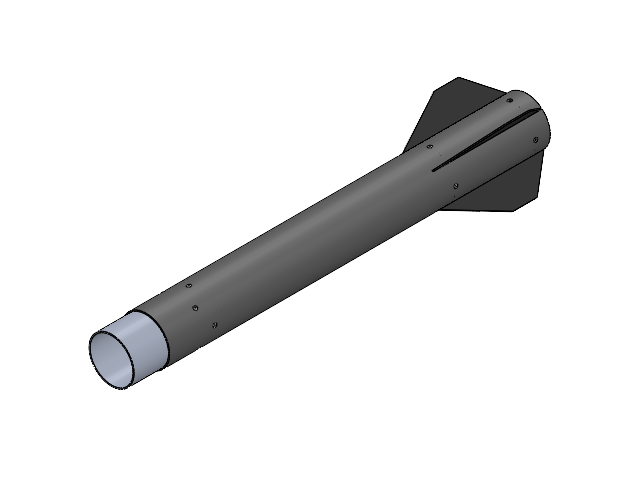
[picture p77: CAD file, 2025-07-06]
mechanics/Alt Gövde Montaj.SLDASM
alt merkezleme bloğu
üst merkezleme 2025
çöp gövde x 4
Asıl Üst Motor Tutucu
2025 ROKET ALT MOTOR TUTUCU
socket head cap screw_iso x 12
Entegrasyon gövdesi
M1850
Alt Gövde
socket countersunk head screw_iso x 15
