RaX0r39/Trakya-Rocket-Unfinished/mechanics/Burun Konisi Montaj 2025.SLDASM

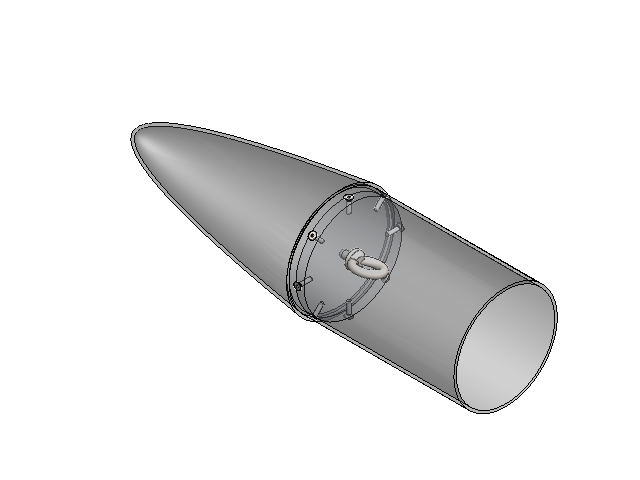
[picture p78: CAD file, 2025-07-06]
mechanics/Burun Konisi Montaj 2025.SLDASM
burun konisi havşalı
burun konisi duvarı
socket countersunk head screw_iso x 8
M8 EYEBOLT
