RaX0r39/Trakya-Rocket-Unfinished/(list of files, cad)

Other CAD files:
mechanics/M8 EYEBOLT.SLDPRT
mechanics/MAPA M8 EYEBOLT.SLDPRT
mechanics/hex nut gradec_iso.sldprt
mechanics/lm2596.SLDPRT
mechanics/pan head cross recess screw_din.sldprt
mechanics/socket countersunk head screw_iso.sldprt
mechanics/socket head cap screw_iso.sldprt
